Abbegubbegum/RP_port_tester_v0/RP_port_tester_v0.step

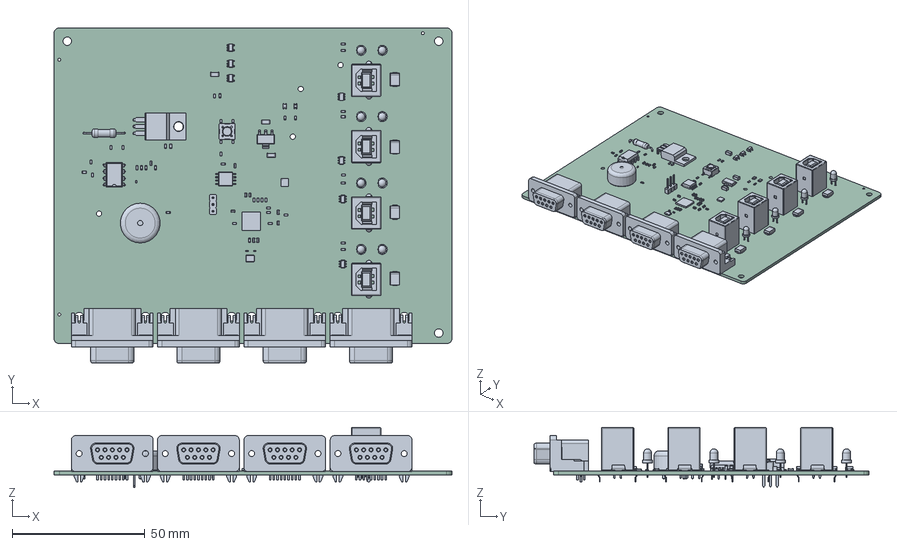
[picture p1: CAD file, 2025-10-20]
RP_port_tester_v0.step
150.0 x 126.3 x 22.7 mm
R_0603_1608Metric x 28
C_0603_1608Metric x 17
LED_D3.0mm x 8
SW_SPST_PTS645Sx43SMTR92
D_SMB x 4
D_0805_2012Metric x 2
SOT-23-5 x 3
SOIC-8_5.3x5.3mm_P1.27mm
QFN-16-1EP_3x3mm_P0.5mm_EP1.7x1.7mm
Cover x 4
Inner x 4
pin x 16
C_1206_3216Metric x 3
DIP-8_W7.62mm
Buzzer_15x7.5RM7.6
TO-220-3_Horizontal_TabDown
QFN-56-1EP_7x7mm_P0.4mm_EP3.2x3.2mm
C_0402_1005Metric x 3
SOT-23-6 x 4
Crystal_SMD_Abracon_ABM8G-4Pin_3.2x2.5mm
SOT-223
R_Axial_DIN0309_L9.0mm_D3.2mm_P15.24mm_Horizontal
PinHeader_1x03_P2.54mm_Vertical
RP_port_tester_v0_PCB
