Abbegubbegum/RP_port_tester_v0/RP_port_tester_v0.kicad_pcb

## KiCad design RP_port_tester_v0.kicad_pcb (2025-10-20)

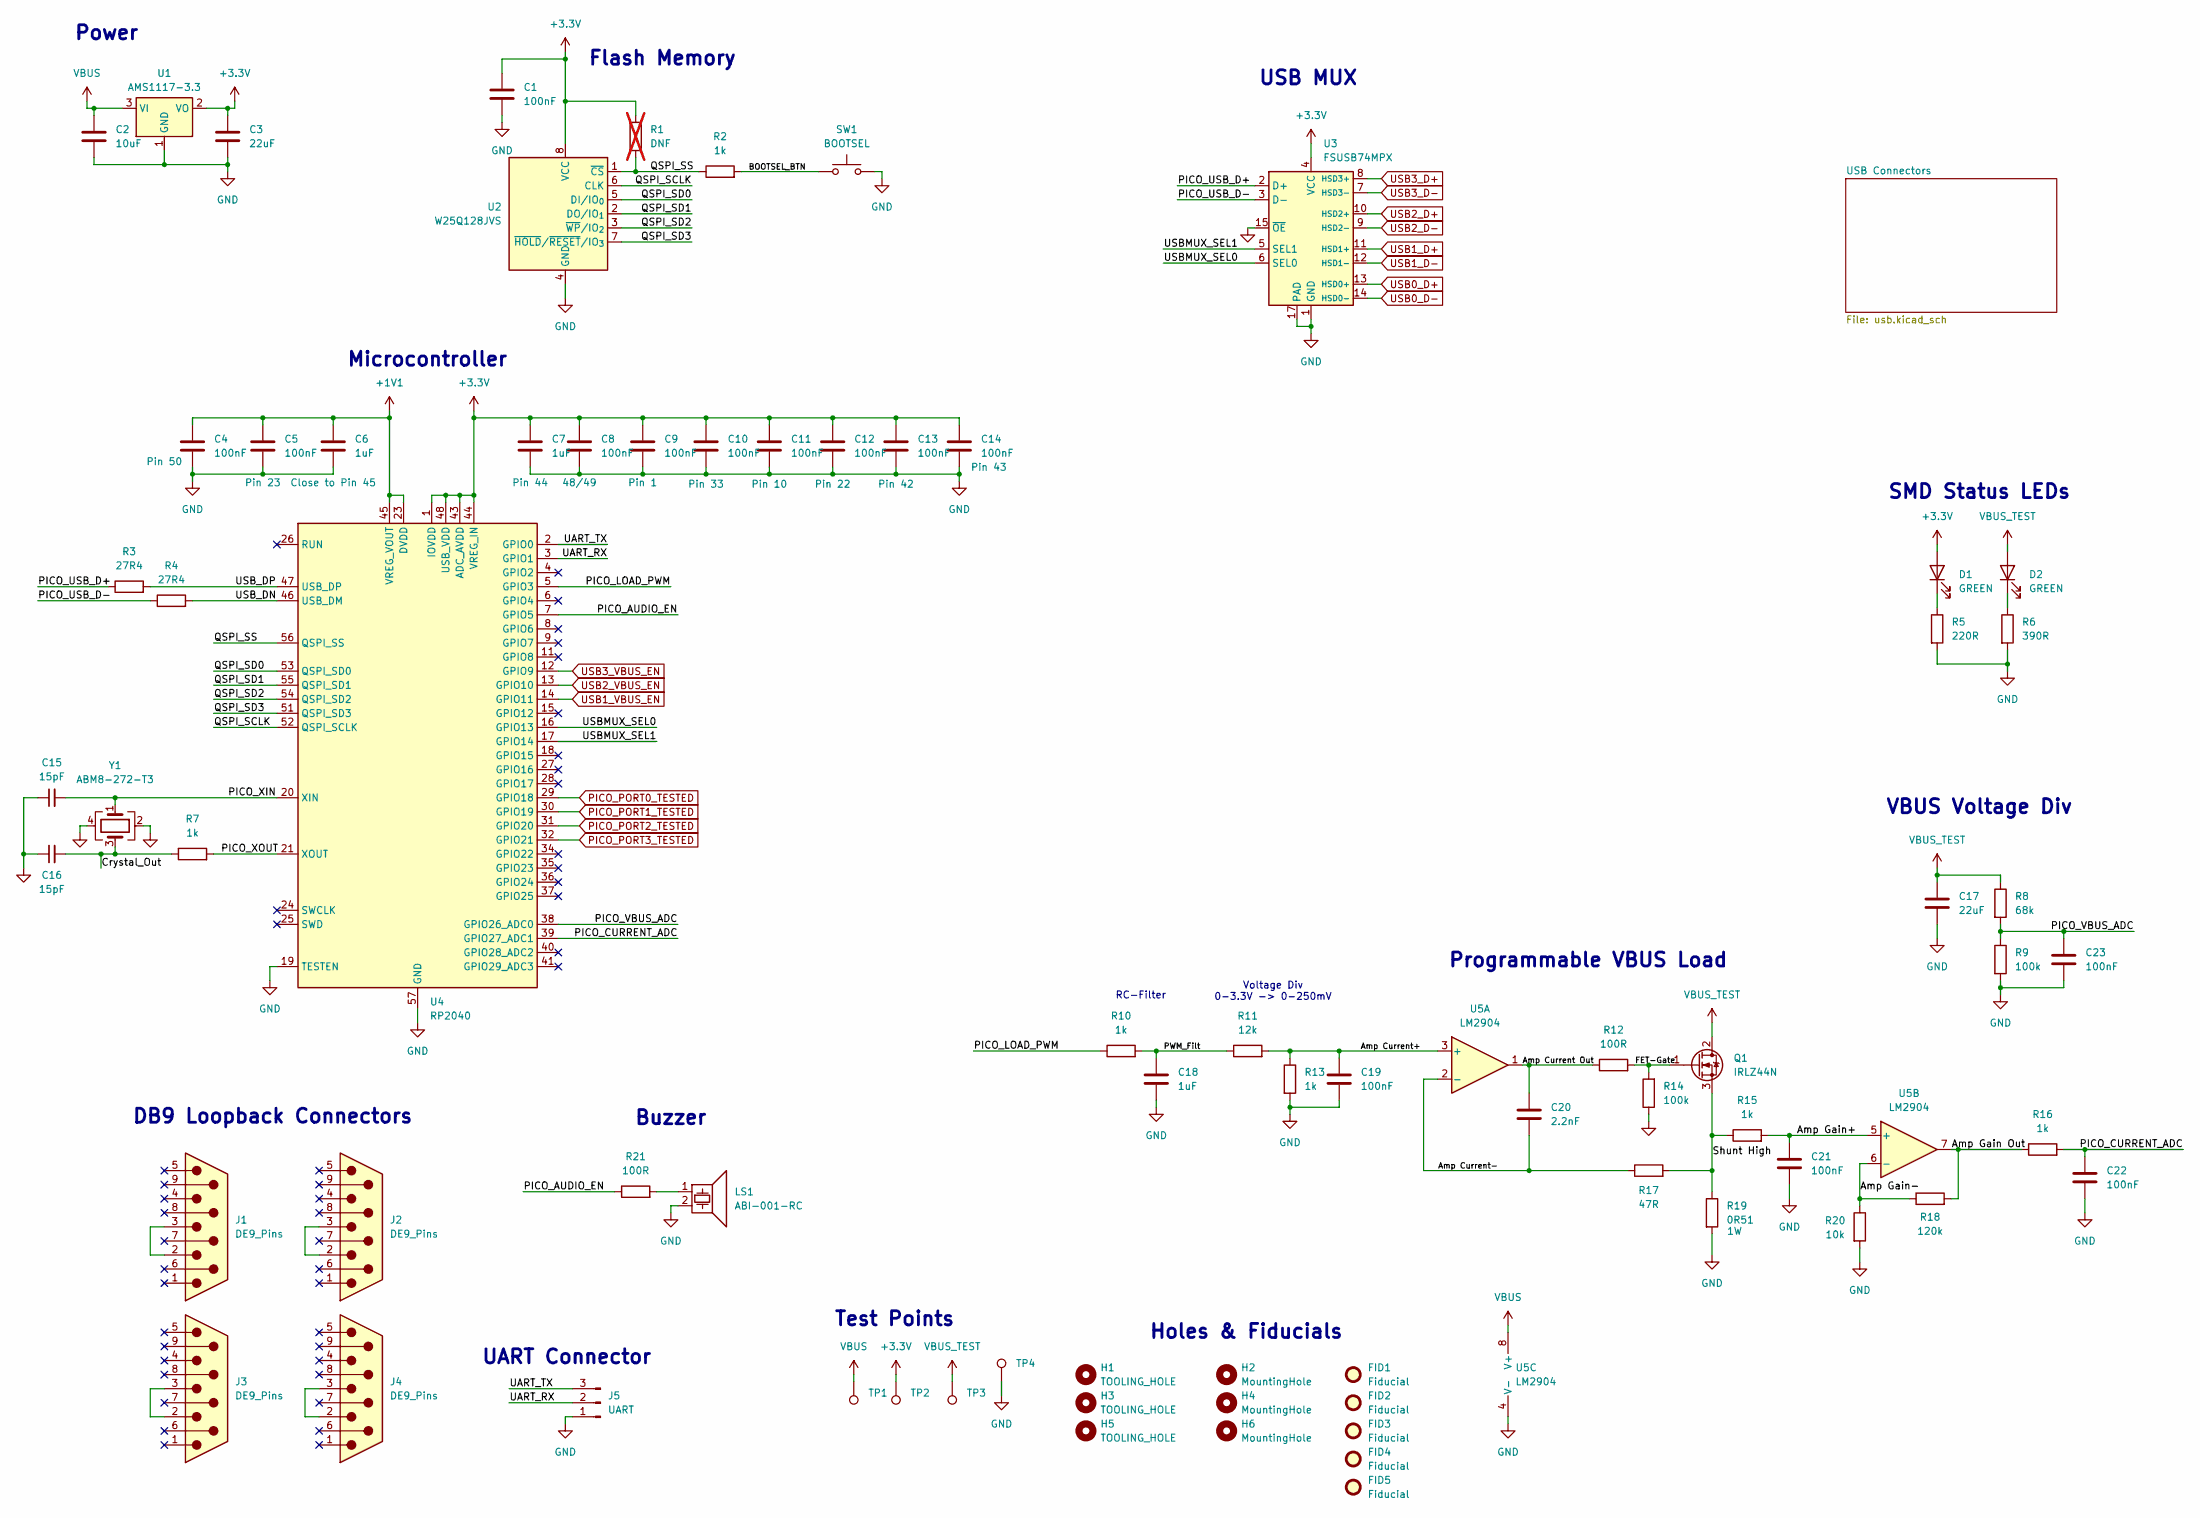
[picture p2: schematic RP_port_tester_v0.kicad_sch]

Parts:
C1, C4, C5, C8, C9, C10, C11, C12, C13, C14, C19, C21, C22, C23: 100nF; C_0603_1608Metric_Pad1.08x0.95mm_HandSolder
C2: 10uF; C_1206_3216Metric_Pad1.33x1.80mm_HandSolder
C3, C17: 22uF; C_1206_3216Metric_Pad1.33x1.80mm_HandSolder
C6, C7, C18: 1uF; C_0603_1608Metric_Pad1.08x0.95mm_HandSolder
C15, C16: 15pF; C_0402_1005Metric_Pad0.74x0.62mm_HandSolder
C20: 2.2nF; C_0402_1005Metric_Pad0.74x0.62mm_HandSolder
D1, D2: GREEN; D_0805_2012Metric_Pad1.15x1.40mm_HandSolder
FID1, FID2, FID3, FID4, FID5: Fiducial; Fiducial_1mm_Mask2mm
H1, H3, H5: TOOLING_HOLE; ToolingHole_1.152mm
H2, H4, H6: MountingHole; MountingHole_3.2mm_M3
J1, J2, J3, J4: DE9_Pins; DB9_Horizontal
J5: UART; PinHeader_1x03_P2.54mm_Vertical
LS1: ABI-001-RC; Buzzer_15x7.5RM7.6
Q1: IRLZ44N; TO-220-3_Horizontal_TabDown
R1: DNF; R_0603_1608Metric_Pad0.98x0.95mm_HandSolder; not fitted
R2, R7, R10, R13, R15, R16: 1k; R_0603_1608Metric_Pad0.98x0.95mm_HandSolder
R3, R4: 27R4; R_0603_1608Metric_Pad0.98x0.95mm_HandSolder
R5: 220R; R_0603_1608Metric_Pad0.98x0.95mm_HandSolder
R6: 390R; R_0603_1608Metric_Pad0.98x0.95mm_HandSolder
R8: 68k; R_0603_1608Metric_Pad0.98x0.95mm_HandSolder
R9, R14: 100k; R_0603_1608Metric_Pad0.98x0.95mm_HandSolder
R11: 12k; R_0603_1608Metric_Pad0.98x0.95mm_HandSolder
R12, R21: 100R; R_0603_1608Metric_Pad0.98x0.95mm_HandSolder
R17: 47R; R_0603_1608Metric_Pad0.98x0.95mm_HandSolder
R18: 120k; R_0603_1608Metric_Pad0.98x0.95mm_HandSolder
R19: 0R51; R_Axial_DIN0309_L9.0mm_D3.2mm_P15.24mm_Horizontal
R20: 10k; R_0603_1608Metric_Pad0.98x0.95mm_HandSolder
SW1: BOOTSEL; SW_SPST_PTS645Sx43SMTR92
TP1, TP2, TP3, TP4: TestPoint; TestPoint_Plated_Hole_D2.0mm
U1: AMS1117-3.3; SOT-223-3_TabPin2
U2: W25Q128JVS; SOIC-8_5.3x5.3mm_P1.27mm
U3: FSUSB74MPX; QFN-16-1EP_3x3mm_P0.5mm_EP1.7x1.7mm_ThermalVias
U4: RP2040; QFN-56-1EP_7x7mm_P0.4mm_EP3.2x3.2mm_ThermalVias
U5: LM2904; DIP-8_W7.62mm
Y1: ABM8-272-T3; Crystal_SMD_Abracon_ABM8G-4Pin_3.2x2.5mm

Connections:
+1V1: C4.1, C5.1, C6.1, U4.23 (DVDD), U4.45 (VREG_VOUT), U4.50 (DVDD)
+3.3V: C1.1, C3.1, C7.1, C8.1, C9.1, C10.1, C11.1, C12.1, C13.1, C14.1, D1.2 (A), R1.1, TP2.1, U1.2 (VO), U2.8 (VCC), U3.4 (VCC), U4.1 (IOVDD), U4.10 (IOVDD), U4.22 (IOVDD), U4.33 (IOVDD), U4.42 (IOVDD), U4.43 (ADC_AVDD), U4.44 (VREG_IN), U4.48 (USB_VDD), U4.49 (IOVDD)
/Amp Current Out: C20.1, R12.1, U5.1
/Amp Current+: C19.1, R11.2, R13.1, U5.3 (+)
/Amp Current-: C20.2, R17.1, U5.2 (-)
/Amp Gain Out: R16.1, R18.2, U5.7
/Amp Gain+: C21.1, R15.2, U5.5 (+)
/Amp Gain-: R18.1, R20.1, U5.6 (-)
/BOOTSEL_BTN: R2.2, SW1.1
/Crystal_Out: C16.2, R7.1, Y1.3
/FET-Gate: Q1.1 (G), R12.2, R14.2
/PICO_AUDIO_EN: R21.1, U4.7 (GPIO5)
/PICO_CURRENT_ADC: C22.1, R16.2, U4.39 (GPIO27_ADC1)
/PICO_LOAD_PWM: R10.1, U4.5 (GPIO3)
/PICO_USB_D+: R3.1, U3.2 (D+)
/PICO_USB_D-: R4.1, U3.3 (D-)
/PICO_VBUS_ADC: C23.1, R8.2, R9.1, U4.38 (GPIO26_ADC0)
/PICO_XIN: C15.2, U4.20 (XIN), Y1.1
/PICO_XOUT: R7.2, U4.21 (XOUT)
/PWM_Filt: C18.1, R10.2, R11.1
/QSPI_SCLK: U2.6 (CLK), U4.52 (QSPI_SCLK)
/QSPI_SD0: U2.5 (DI/IO_{0}), U4.53 (QSPI_SD0)
/QSPI_SD1: U2.2 (DO/IO_{1}), U4.55 (QSPI_SD1)
/QSPI_SD2: U2.3 (~WP/IO_{2}), U4.54 (QSPI_SD2)
/QSPI_SD3: U2.7 (~HOLD/~RESET/IO_{3}), U4.51 (QSPI_SD3)
/QSPI_SS: R1.2, R2.1, U2.1 (~CS), U4.56 (QSPI_SS)
/Shunt High: Q1.3 (S), R15.1, R17.2, R19.1
/UART_RX: J5.2, U4.3 (GPIO1)
/UART_TX: J5.3, U4.2 (GPIO0)
/USBMUX_SEL0: U3.6 (SEL0), U4.16 (GPIO13)
/USBMUX_SEL1: U3.5 (SEL1), U4.17 (GPIO14)
/USB_DN: R4.2, U4.46 (USB_DM)
/USB_DP: R3.2, U4.47 (USB_DP)
GND: C1.2, C2.2, C3.2, C4.2, C5.2, C6.2, C7.2, C8.2, C9.2, C10.2, C11.2, C12.2, C13.2, C14.2, C15.1, C16.1, C17.2, C18.2, C19.2, C21.2, C22.2, C23.2, J5.1, LS1.2, R5.2, R6.2, R9.2, R13.2, R14.1, R19.2, R20.2, SW1.2, TP4.1, U1.1 (GND), U2.4 (GND), U3.1 (GND), U3.15 (~OE), U3.17 (PAD), U4.19 (TESTEN), U4.57 (GND), U5.4 (V-), Y1.2, Y1.4; also elsewhere on the board
unnamed: D1.1 (K), R5.1
unnamed: D2.1 (K), R6.1
unnamed: J1.2, J1.3
unnamed: J2.2, J2.3
unnamed: J3.2, J3.3
unnamed: J4.2, J4.3
unnamed: LS1.1, R21.2
PICO_PORT0_TESTED: U4.29 (GPIO18); also elsewhere on the board
PICO_PORT1_TESTED: U4.30 (GPIO19); also elsewhere on the board
PICO_PORT2_TESTED: U4.31 (GPIO20); also elsewhere on the board
PICO_PORT3_TESTED: U4.32 (GPIO21); also elsewhere on the board
USB0_D+: U3.13 (HSD0+); also elsewhere on the board
USB0_D-: U3.14 (HSD0-); also elsewhere on the board
USB1_D+: U3.11 (HSD1+); also elsewhere on the board
USB1_D-: U3.12 (HSD1-); also elsewhere on the board
USB1_VBUS_EN: U4.14 (GPIO11); also elsewhere on the board
USB2_D+: U3.10 (HSD2+); also elsewhere on the board
USB2_D-: U3.9 (HSD2-); also elsewhere on the board
USB2_VBUS_EN: U4.13 (GPIO10); also elsewhere on the board
USB3_D+: U3.8 (HSD3+); also elsewhere on the board
USB3_D-: U3.7 (HSD3-); also elsewhere on the board
USB3_VBUS_EN: U4.12 (GPIO9); also elsewhere on the board
VBUS: C2.1, TP1.1, U1.3 (VI), U5.8 (V+); also elsewhere on the board
VBUS_TEST: C17.1, D2.2 (A), Q1.2 (D), R8.1, TP3.1; also elsewhere on the board

Notes on the sheet:
DB9 Loopback Connectors
Microcontroller
Voltage Div 0-3.3V -> 0-250mV
Programmable VBUS Load
Power
RC-Filter
SMD Status LEDs
Buzzer
Flash Memory
Holes & Fiducials
USB MUX
VBUS Voltage Div
UART Connector
Test Points

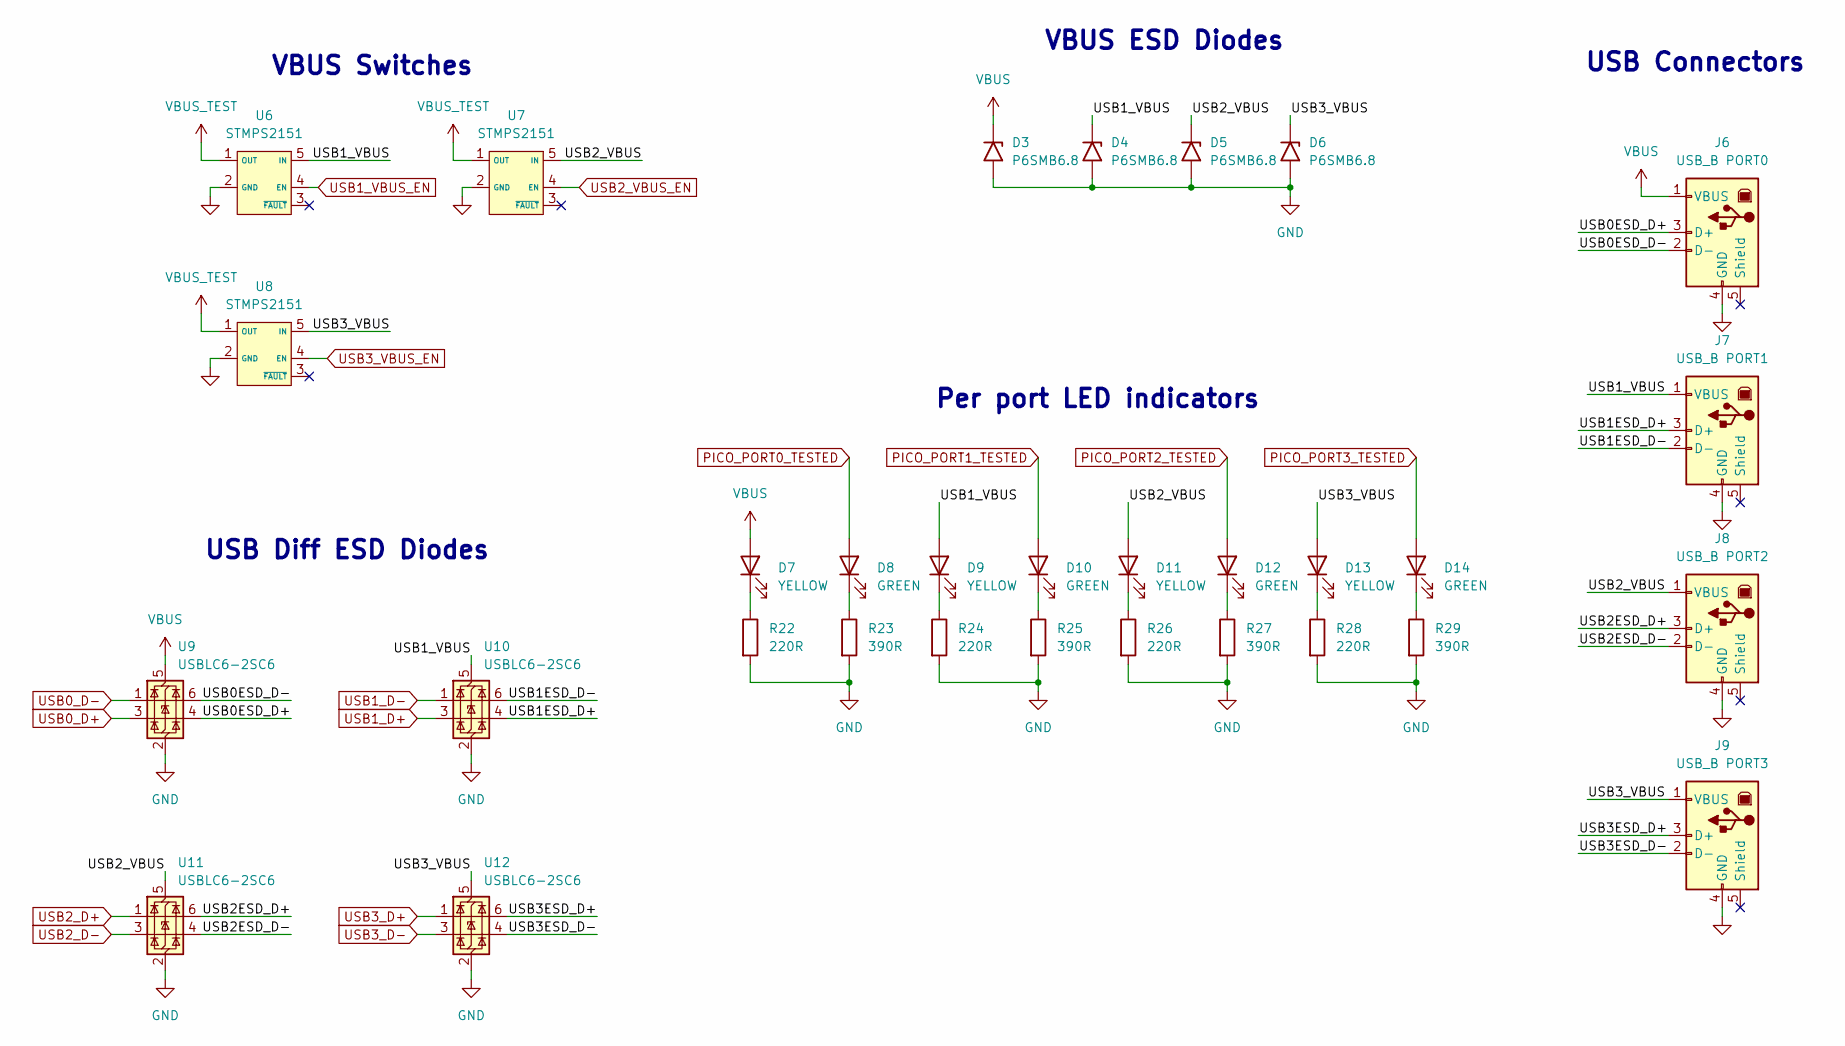
[picture p3: schematic usb.kicad_sch]

Parts:
D3, D4, D5, D6: P6SMB6.8; D_SMB
D7, D9, D11, D13: YELLOW; LED_D3.0mm
D8, D10, D12, D14: GREEN; LED_D3.0mm
J6: USB_B PORT0; USB_B_Vertical
J7: USB_B PORT1; USB_B_Vertical
J8: USB_B PORT2; USB_B_Vertical
J9: USB_B PORT3; USB_B_Vertical
R22, R24, R26, R28: 220R; R_0603_1608Metric_Pad0.98x0.95mm_HandSolder
R23, R25, R27, R29: 390R; R_0603_1608Metric_Pad0.98x0.95mm_HandSolder
U6, U7, U8: STMPS2151; SOT-23-5_HandSoldering
U9, U10, U11, U12: USBLC6-2SC6; SOT-23-6

Connections:
/USB Connectors/USB0ESD_D+: J6.3 (D+), U9.4 (I/O2)
/USB Connectors/USB0ESD_D-: J6.2 (D-), U9.6 (I/O1)
/USB Connectors/USB1ESD_D+: J7.3 (D+), U10.4 (I/O2)
/USB Connectors/USB1ESD_D-: J7.2 (D-), U10.6 (I/O1)
/USB Connectors/USB1_VBUS: D4.1 (A1), D9.2 (A), J7.1 (VBUS), U6.5 (IN), U10.5 (VBUS)
/USB Connectors/USB2ESD_D+: J8.3 (D+), U11.6 (I/O1)
/USB Connectors/USB2ESD_D-: J8.2 (D-), U11.4 (I/O2)
/USB Connectors/USB2_VBUS: D5.1 (A1), D11.2 (A), J8.1 (VBUS), U7.5 (IN), U11.5 (VBUS)
/USB Connectors/USB3ESD_D+: J9.3 (D+), U12.6 (I/O1)
/USB Connectors/USB3ESD_D-: J9.2 (D-), U12.4 (I/O2)
/USB Connectors/USB3_VBUS: D6.1 (A1), D13.2 (A), J9.1 (VBUS), U8.5 (IN), U12.5 (VBUS)
GND: D3.2 (A2), D4.2 (A2), D5.2 (A2), D6.2 (A2), J6.4 (GND), J7.4 (GND), J8.4 (GND), J9.4 (GND), R22.2, R23.2, R24.2, R25.2, R26.2, R27.2, R28.2, R29.2, U6.2 (GND), U7.2 (GND), U8.2 (GND), U9.2 (GND), U10.2 (GND), U11.2 (GND), U12.2 (GND); also elsewhere on the board
unnamed: D7.1 (K), R22.1
unnamed: D8.1 (K), R23.1
unnamed: D9.1 (K), R24.1
unnamed: D10.1 (K), R25.1
unnamed: D11.1 (K), R26.1
unnamed: D12.1 (K), R27.1
unnamed: D13.1 (K), R28.1
unnamed: D14.1 (K), R29.1
PICO_PORT0_TESTED: D8.2 (A); also elsewhere on the board
PICO_PORT1_TESTED: D10.2 (A); also elsewhere on the board
PICO_PORT2_TESTED: D12.2 (A); also elsewhere on the board
PICO_PORT3_TESTED: D14.2 (A); also elsewhere on the board
USB0_D+: U9.3 (I/O2); also elsewhere on the board
USB0_D-: U9.1 (I/O1); also elsewhere on the board
USB1_D+: U10.3 (I/O2); also elsewhere on the board
USB1_D-: U10.1 (I/O1); also elsewhere on the board
USB1_VBUS_EN: U6.4 (EN); also elsewhere on the board
USB2_D+: U11.1 (I/O1); also elsewhere on the board
USB2_D-: U11.3 (I/O2); also elsewhere on the board
USB2_VBUS_EN: U7.4 (EN); also elsewhere on the board
USB3_D+: U12.1 (I/O1); also elsewhere on the board
USB3_D-: U12.3 (I/O2); also elsewhere on the board
USB3_VBUS_EN: U8.4 (EN); also elsewhere on the board
VBUS: D3.1 (A1), D7.2 (A), J6.1 (VBUS), U9.5 (VBUS); also elsewhere on the board
VBUS_TEST: U6.1 (OUT), U7.1 (OUT), U8.1 (OUT); also elsewhere on the board

Notes on the sheet:
VBUS ESD Diodes
USB Diff ESD Diodes
VBUS Switches
Per port LED indicators
USB Connectors

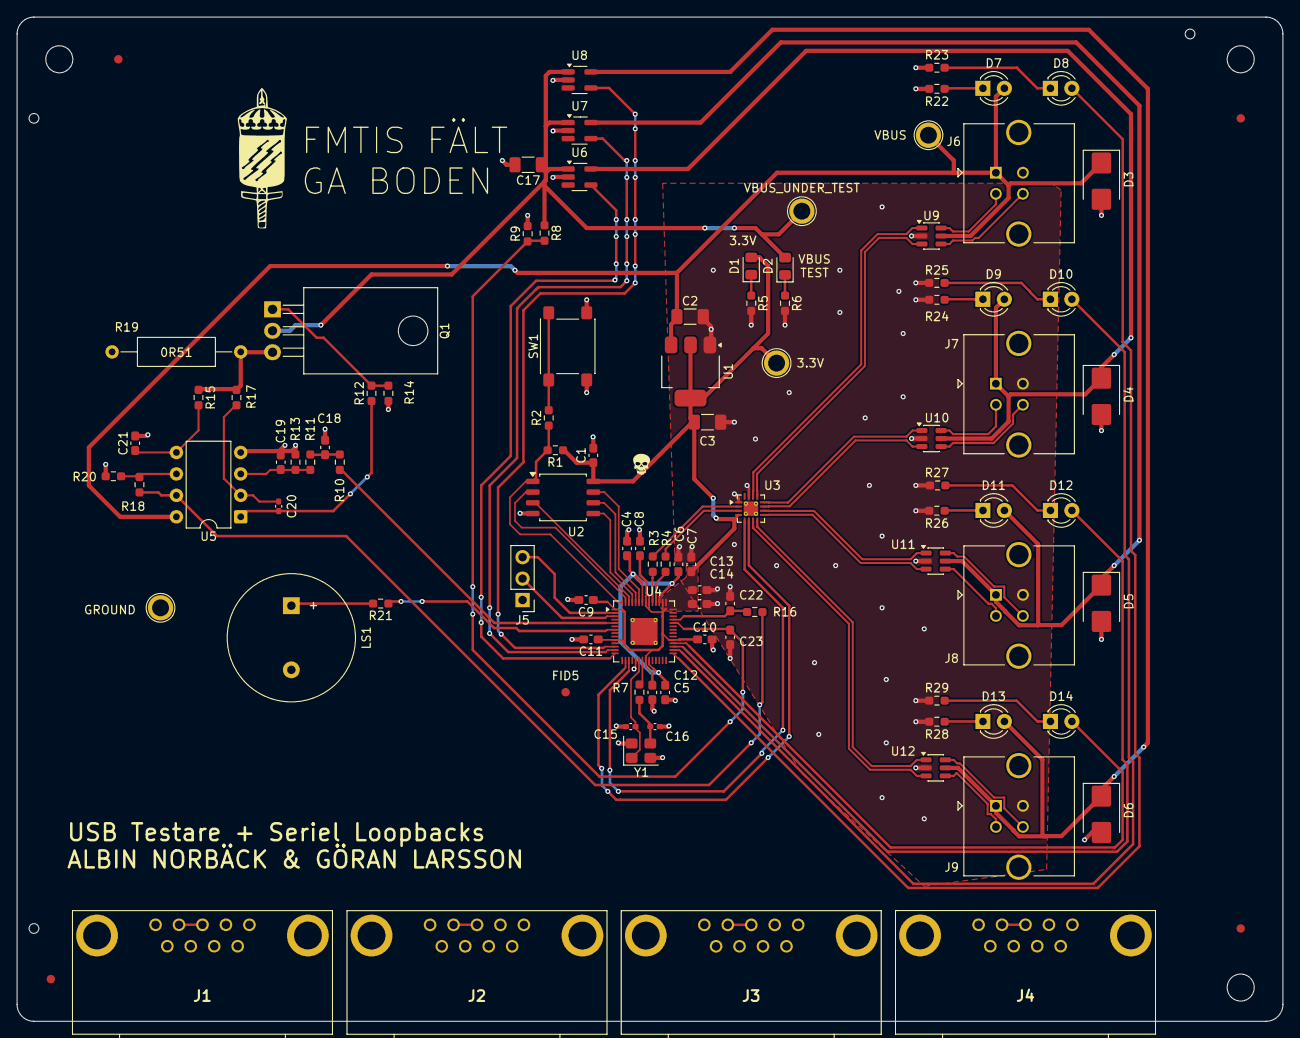
[picture p4: board RP_port_tester_v0.kicad_pcb from above]

Board: 2 copper layers, 150.0 x 119.0 mm, 106 parts (0 on the bottom side), 77 nets.
