Abbegubbegum/RP_port_tester_v0/(commit log)

2025-10-15 Initial Schematic and component selection
    [RP_port_tester_v0.kicad_pcb, RP_port_tester_v0.kicad_sch]
2025-10-16 Layout and Tracing
    [RP_port_tester_v0.kicad_pcb, RP_port_tester_v0.kicad_sch, usb.kicad_sch]
2025-10-20 Final layout and routing
    [RP_port_tester_v0.kicad_pcb, RP_port_tester_v0.kicad_sch, RP_port_tester_v0.step, usb.kicad_sch]
2025-10-20 Fix DB9 port misalignment
    [RP_port_tester_v0.kicad_pcb]
